pilotgary/PGRCtool/README.md

# PGRCTool

**RC PWM Signal Analyzer & Generator for the ESP32-S3**

PGRCTool is a compact handheld tool for generating, viewing and analysing hobby RC PWM servo signals using an ESP32-S3 and a 128×64 OLED display.

Designed primarily for RC aircraft, robotics and embedded development, it combines a precision servo signal generator with a real-time PWM analyser in a simple single-button user interface.

---

## Features

### Servo Signal Generator

- Standard 50 Hz RC servo output
- Preset pulse widths
- Continuous waveform generation
- Multiple sweep modes:
  - Sine
  - Triangle
  - Square
- Smooth non-blocking waveform generation
- Output remains active while using other screens

### PWM Signal Analyzer

Measures incoming PWM signals including:

- Pulse width
- Frame period
- Frame rate
- Signal stability

### Statistics

Displays:

- Average pulse width
- Minimum pulse width
- Maximum pulse width
- Peak-to-peak variation
- Total captured samples

### Display

128 × 64 OLED user interface including:

- Generator screen
- Scope screen
- Statistics screen

### Power

Can be powered from USB or the 5V receiver output.  
- A optional diode can protect the ESP32-S3 regulator if both are connected at the same time or the power supply is reversed.
- Small servos can be powered just from the USB connection.

The PWM output is at 3.3V.  Most servos will work at this level. Certainly all the ones I have tested have worked.

The native ESP32-S3 PWM input is limited to 3.3V.  This is fine for some modern recievers like the Radiomaster ER6 which output the PWM signal at 3.3V, but for a general purpose device a Zener Diode and resistor can be added to allow 3.3 to 5V use.

---

## Hardware

Designed for an ESP32-S3 development board together with:

- SSD1306 128×64 I²C OLED
- One push button
- PWM input
- PWM output

**Optional**

The PWM input and PWM output pins on the ESP32-S3 are 3.3V rated.  Applying 5V to them could damage the ESP32-S3. Adding the low cost parts below will protect the ESP32-S3. These can be sourced from eBay 

- 1N5819 Schottky diode
- BZX55C3V3 Zener Diode
- 1K Resistor

## Pin Assignments

GPIO assignments are defined in:

```
include/config.h
```

Default assignments:

| Function | GPIO |
|---|-----:|
| OLED SCL | 1 |
| OLED SDA | 2 |
| PWM Input | 4 |
| PWM Output | 5 |
| Push Button | 6 |

The PWM output can be looped back to the PWM input for self testing.  The signal generator keeps running in the last set mode while the screen is displaying the PWM input waveform.

---

## Wiring

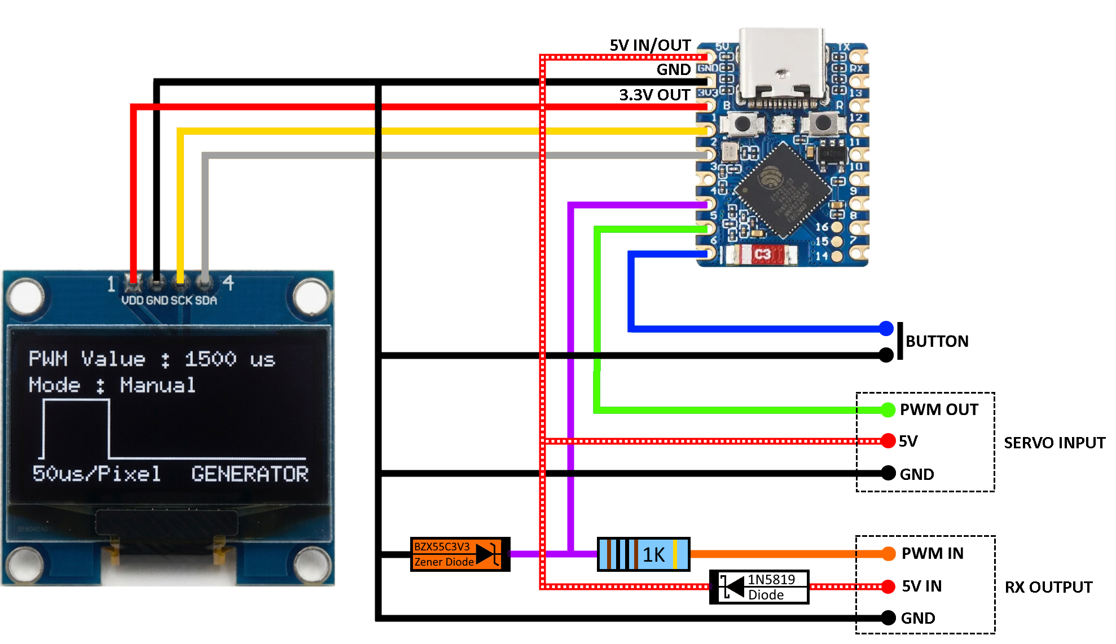
[picture p1: images/Wiring.png]
Wiring Diagram


---

### Case

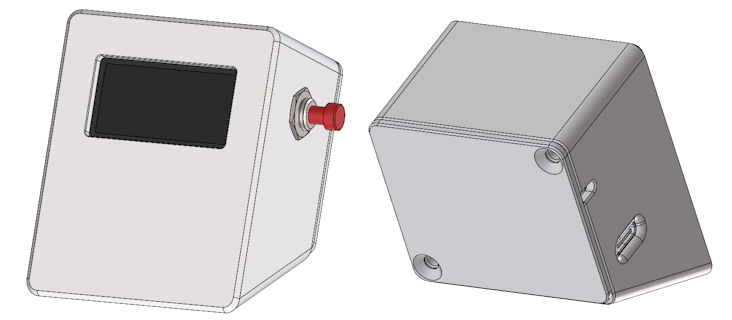
[picture p2: images/3DPrintedCase.png]
3D Printed Case


STEP and STL files for a 3D printed case are available in the repository and on Printables, Thingiverse and Makerworld.

The "3D Printed Case" folder also contains 3MF files for the Snapmaker U1 and the Bambu Labs A1 Mini.

---

## User Interface

The entire application is controlled using a single push button.

### Generator Screen

Displays:

- Output pulse width
- Output frequency
- Current generator mode

Controls:

| Action | Function |
|---|---|
| Short Press | Next preset pulse width (Manual) or next sweep type (Sweep) |
| Double Click | Toggle Manual / Sweep mode |
| Long Press | Switch to Scope screen |

---

### Scope Screen

Displays:

- Measured pulse width
- Frame rate
- Captured waveform

Controls:

| Action | Function |
|---|---|
| Double Click | Statistics screen |
| Long Press | Generator screen |

---

### Statistics Screen

Displays:

- Average pulse width
- Peak-to-peak variation
- Minimum / Maximum pulse width
- Sample count

Controls:

| Action | Function |
|---|---|
| Double Click | Scope screen |
| Long Press | Generator screen |

---

## Project Structure

```
include/
    app.h
    config.h
    version.h

src/
    button.*
    capture.*
    display.*
    generator.*
    hardware.*
    statistics.*
    main.cpp
```

The project is deliberately modular.

| Module | Responsibility |
|---|---|
| Hardware | GPIO, timers and peripherals |
| Button | Button event state machine |
| Generator | PWM output generation |
| Capture | PWM input measurement |
| Statistics | Signal statistics |
| Display | OLED rendering |
| Main | Application state machine |

---

## Software Architecture

The firmware is built around a non-blocking main loop.

Each module owns its own functionality:

- Button event handling
- PWM generation
- PWM capture
- Statistics
- Display rendering

No module performs work that belongs to another, making the code straightforward to extend and maintain.

---

## Building

The project uses **PlatformIO**.

```
pio run
```

Upload:

```
pio run --target upload
```

Monitor:

```
pio device monitor
```

---

## License

This project is released under the MIT License.

---
