pilotgary/PGRCtool/3D Printed Case/PGRCTool-Case-BBL_A1Mini.3mf

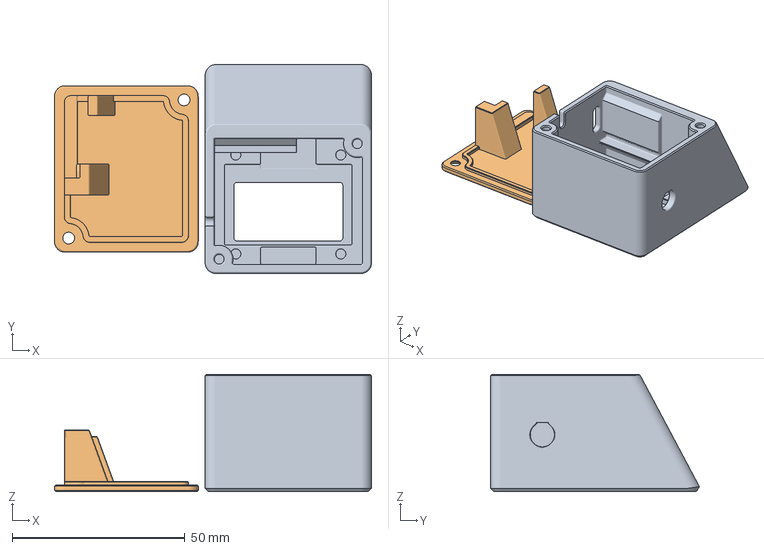
[picture p3: CAD file, 2026-11-11]
3D Printed Case/PGRCTool-Case-BBL_A1Mini.3mf
91.8 x 60.5 x 34.0 mm
PGRCTool-Case_Default
PGRCTool-Back_Default
