pilotgary/PGRCtool/3D Printed Case/PGRCTool-Case-SnapmakerU1.3mf

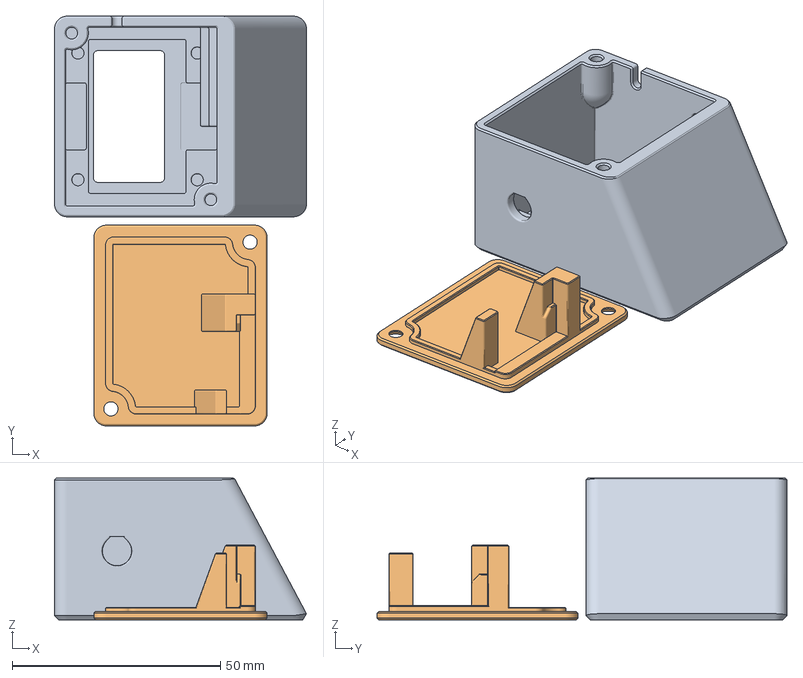
[picture p4: CAD file, 2026-11-11]
3D Printed Case/PGRCTool-Case-SnapmakerU1.3mf
60.5 x 98.3 x 34.0 mm
PGRCTool-Case.STEP
PGRCTool-Back.STEP
