pilotgary/PGRCtool/3D Printed Case/PGRCTool-Case.STEP

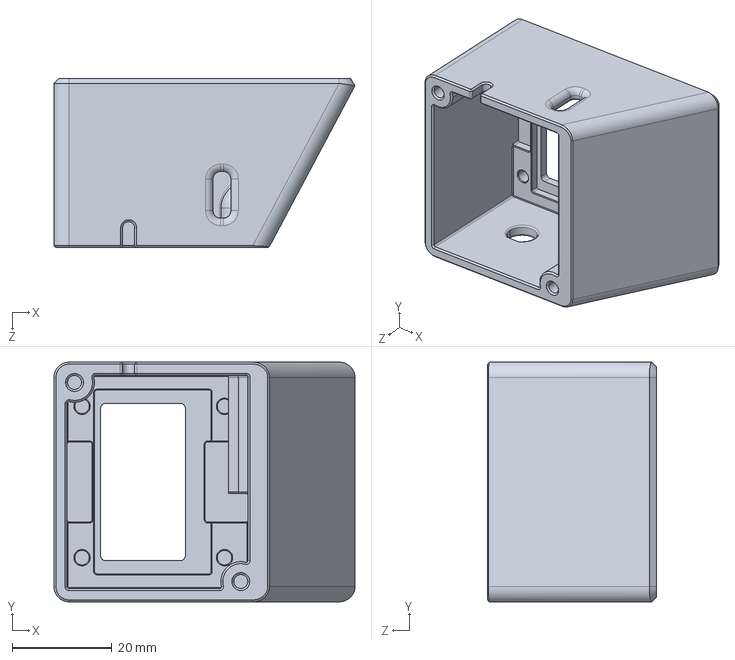
[picture p5: CAD file, 2026-11-11]
3D Printed Case/PGRCTool-Case.STEP
60.5 x 48.2 x 34.0 mm
