pilotgary/PGRCtool/3D Printed Case/PGRCTool-Back.STEP

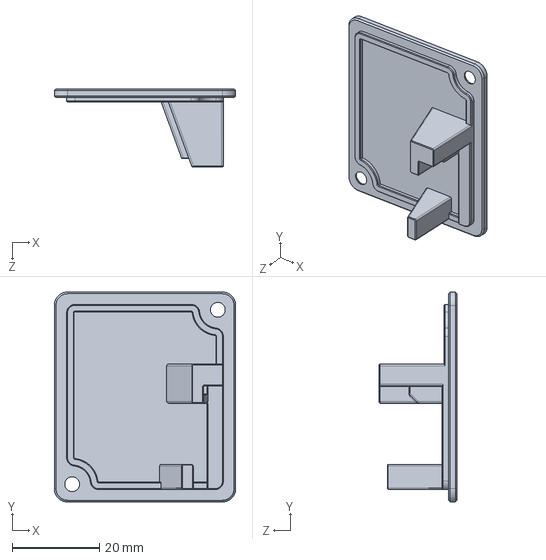
[picture p6: CAD file, 2026-11-11]
3D Printed Case/PGRCTool-Back.STEP
41.6 x 48.2 x 17.9 mm
