pilotgary/PGRCtool/(list of files, cad)

Other CAD files:
3D Printed Case/PGRCTool-Back.STL
3D Printed Case/PGRCTool-Case.STL
