pilotgary/PGRCtool/include/version.h

#pragma once

/**
 * @file version.h
 * @brief PGRCTool firmware version information.
 */

#include <stdint.h>

namespace Version
{
    constexpr uint8_t Major = 2;
    constexpr uint8_t Minor = 0;
    constexpr uint8_t Patch = 0;

    constexpr char Suffix[] = "RC1";

    constexpr char String[] = "2.0.0-RC1";
}
