pilotgary/PGRCtool/(commit log)

2026-07-24 Add voltage warning for PWM pins on ESP32-S3
    Added a note about voltage ratings for PWM pins on ESP32-S3.
2026-07-24 Update README with PWM voltage details and testing info
    Expanded note on PWM input/output voltage ratings and added information about self-testing.
2026-07-24 Change pin order
2026-11-06 Update README with wiring image
2026-11-06 Fix image filename case in README
2026-11-11 Update picture and add case
    [PGRCTool-Back.STEP, PGRCTool-Back.STL, PGRCTool-Case.STEP, PGRCTool-Case.STL]
2026-11-11 Add 3MF
    [PGRCTool-Case-BBL_A1Mini.3mf, PGRCTool-Case-SnapmakerU1.3mf]
2026-11-11 Add 3D printed case details to README
    Added section for 3D printed case with links to files.
2026-11-13 Add diodes
2026-11-13 Update README with power and protection details
    Added information about power options and protection components for the ESP32-S3.
